koson/os/Backplane/renders/3d-full.png

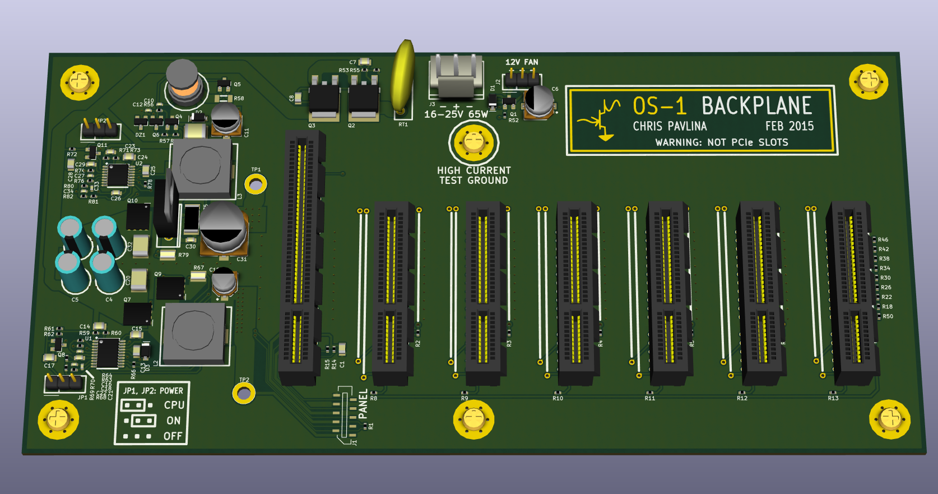
Backplane/renders/3d-full.png
