koson/os/Backplane/renders/render_2l_small.png

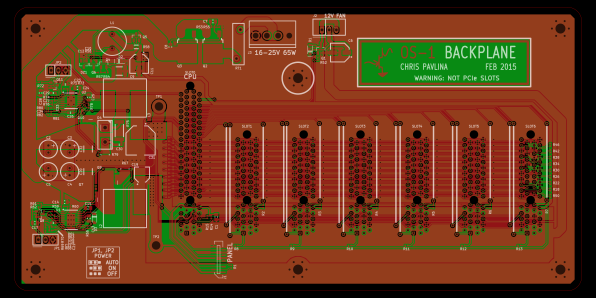
Backplane/renders/render_2l_small.png
