koson/os/README.rst

I'm building an oscilloscope!

See the `project page`_.

.. _`project page`: http://cpavlina.github.io/os/
