koson/os/Backplane/renders/page_os-backplane.png

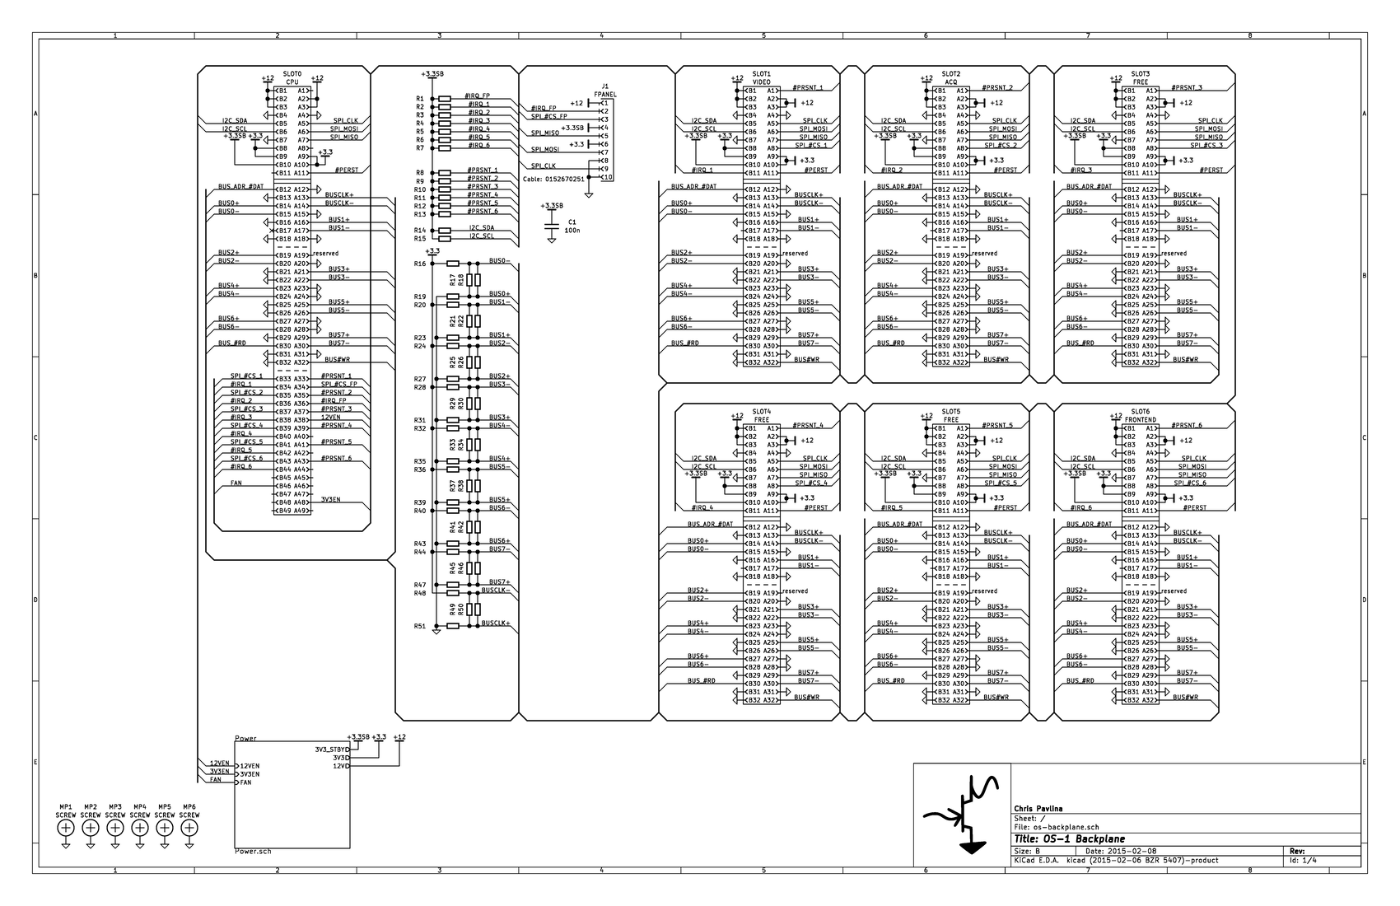
Backplane/renders/page_os-backplane.png
