koson/os/Backplane/renders/page_Power-Power.png

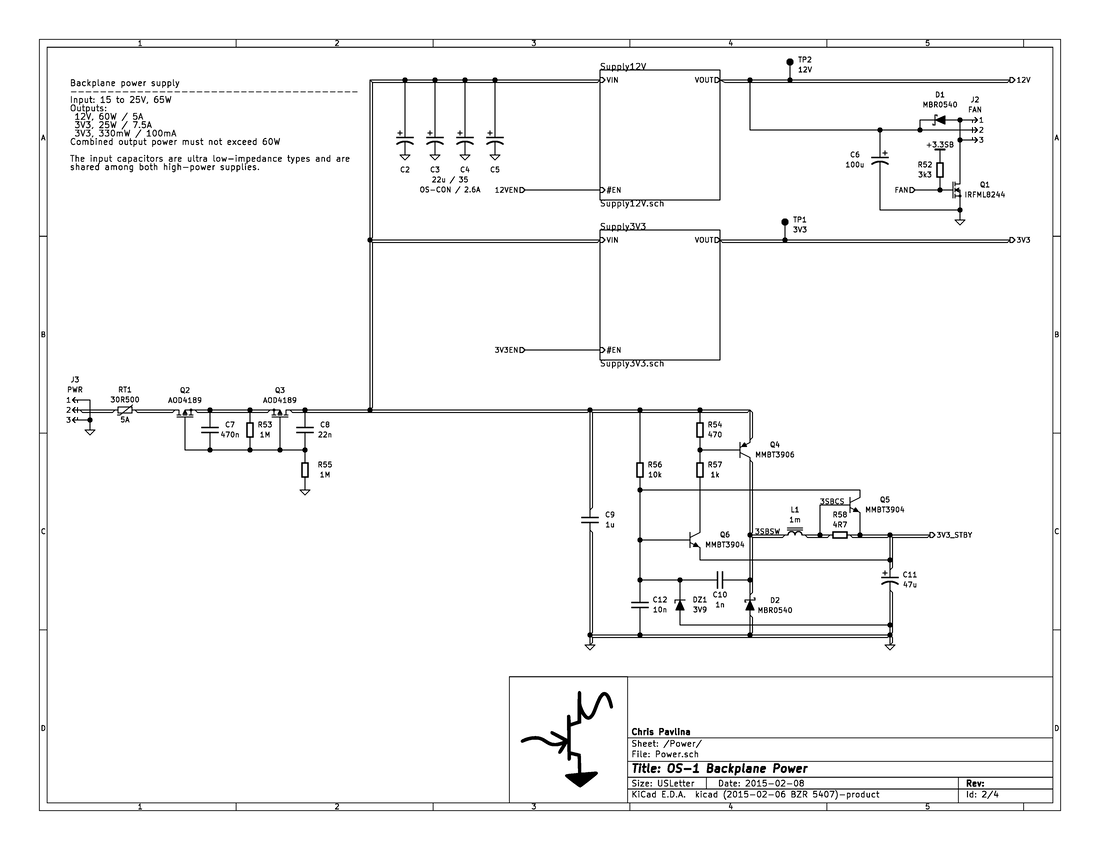
Backplane/renders/page_Power-Power.png
