koson/os/Backplane/renders/page_Supply3V3-Power-Supply3V3.png

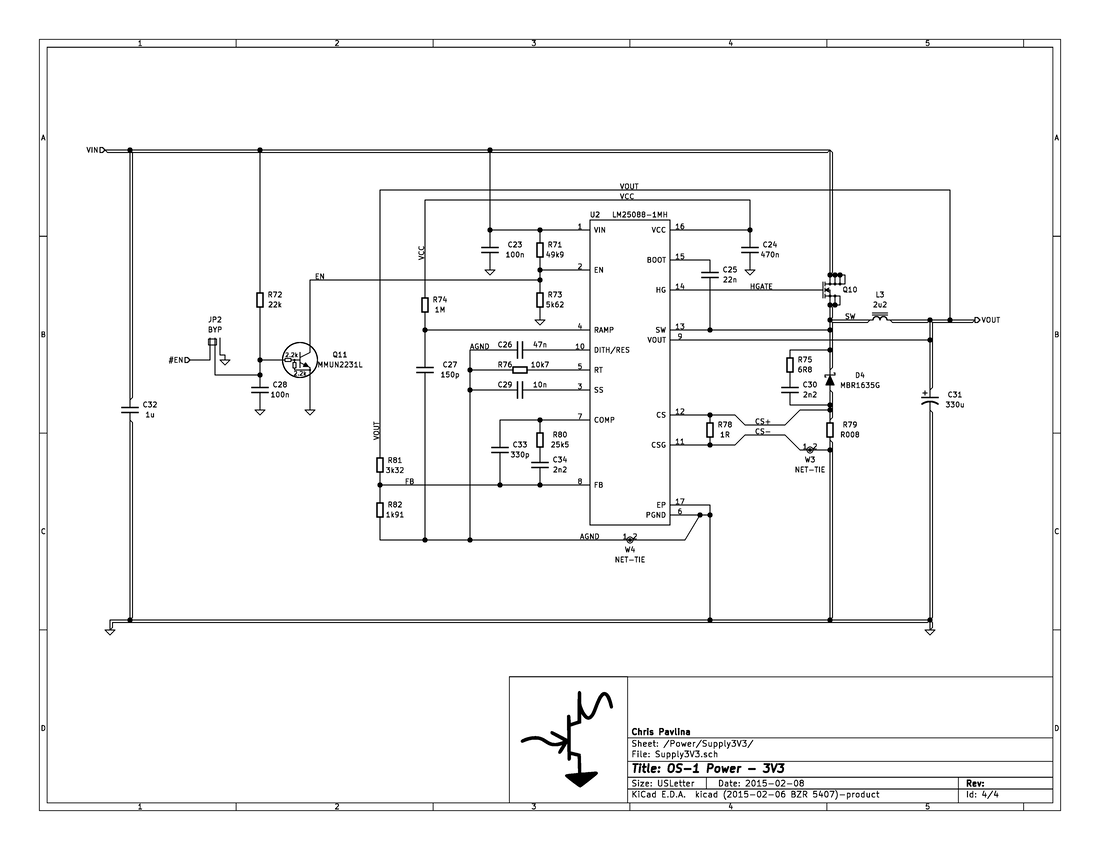
Backplane/renders/page_Supply3V3-Power-Supply3V3.png
