koson/os/Backplane/renders/page_Supply12V-Power-Supply12V.png

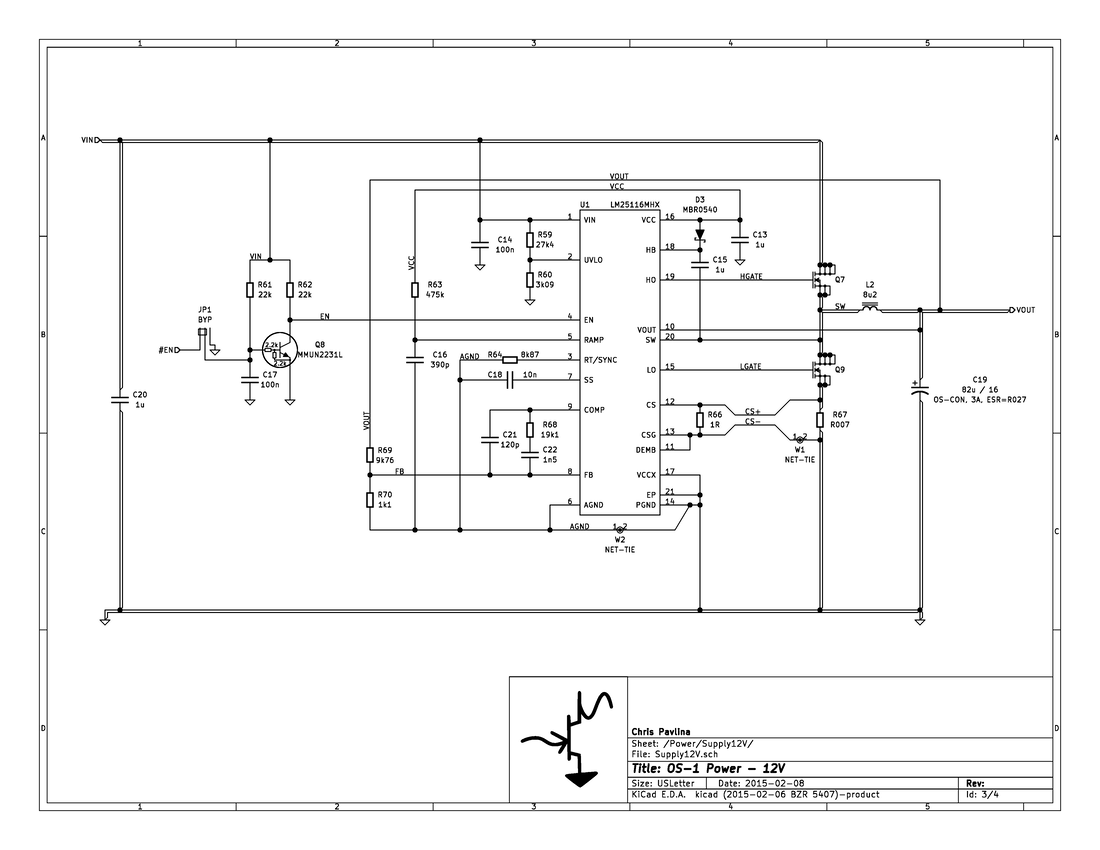
Backplane/renders/page_Supply12V-Power-Supply12V.png
