koson/os/Backplane/renders/render_lyr1.png

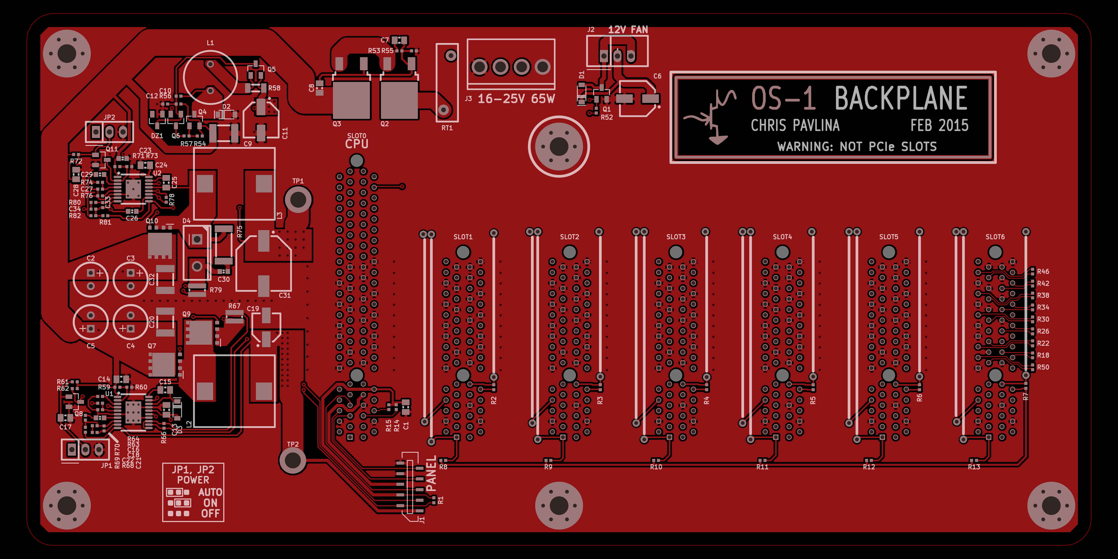
Backplane/renders/render_lyr1.png
