koson/os/Backplane/renders/render_lyr2.png

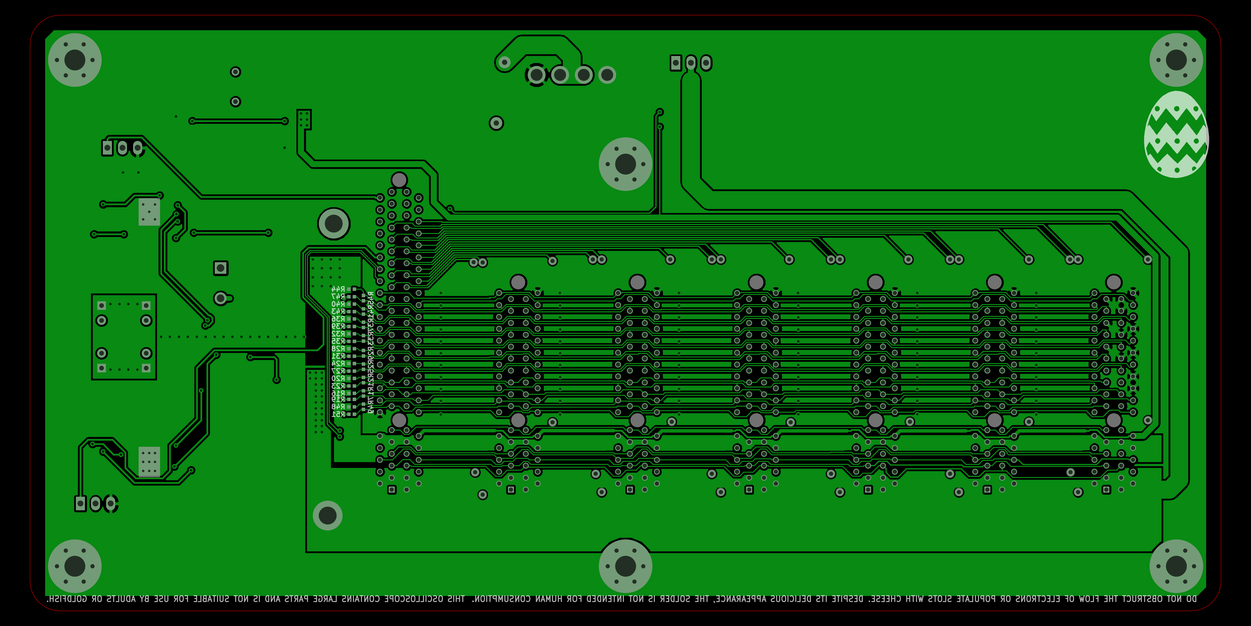
Backplane/renders/render_lyr2.png
