koson/os/Backplane/renders/schematic_small.png

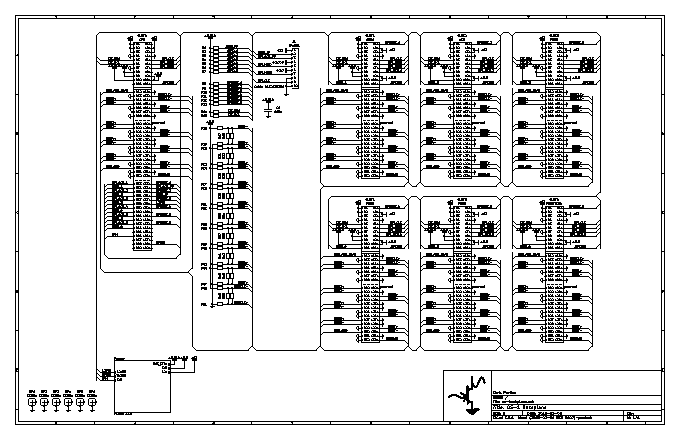
Backplane/renders/schematic_small.png
