koson/os/Frontend/Planning/Attens.png

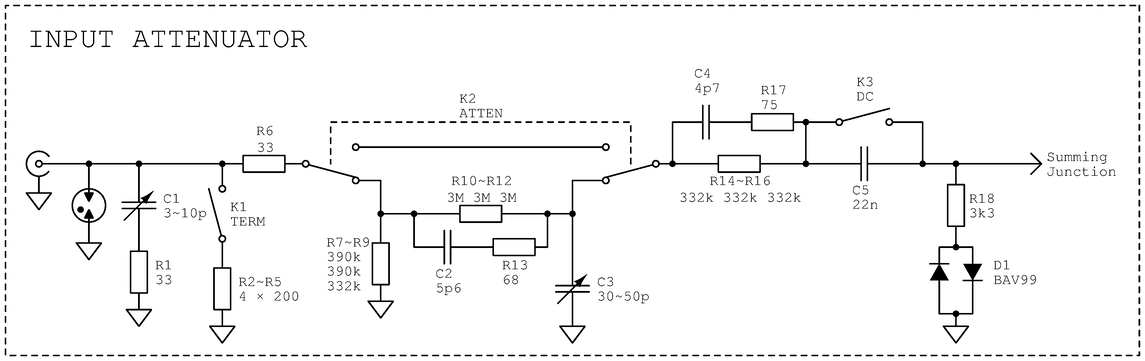
Frontend/Planning/Attens.png
