koson/os/Frontend/Planning/BlockDiag.png

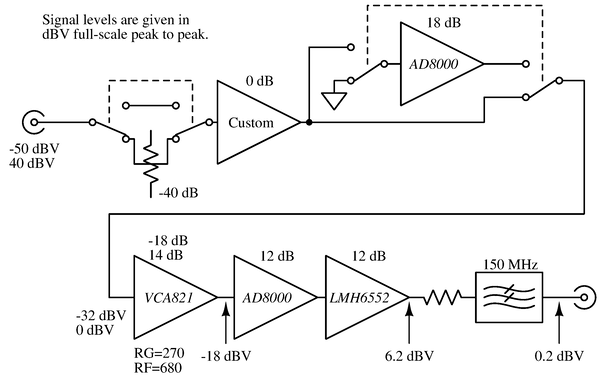
Frontend/Planning/BlockDiag.png
