koson/os/Frontend/renders/B_Cu.png

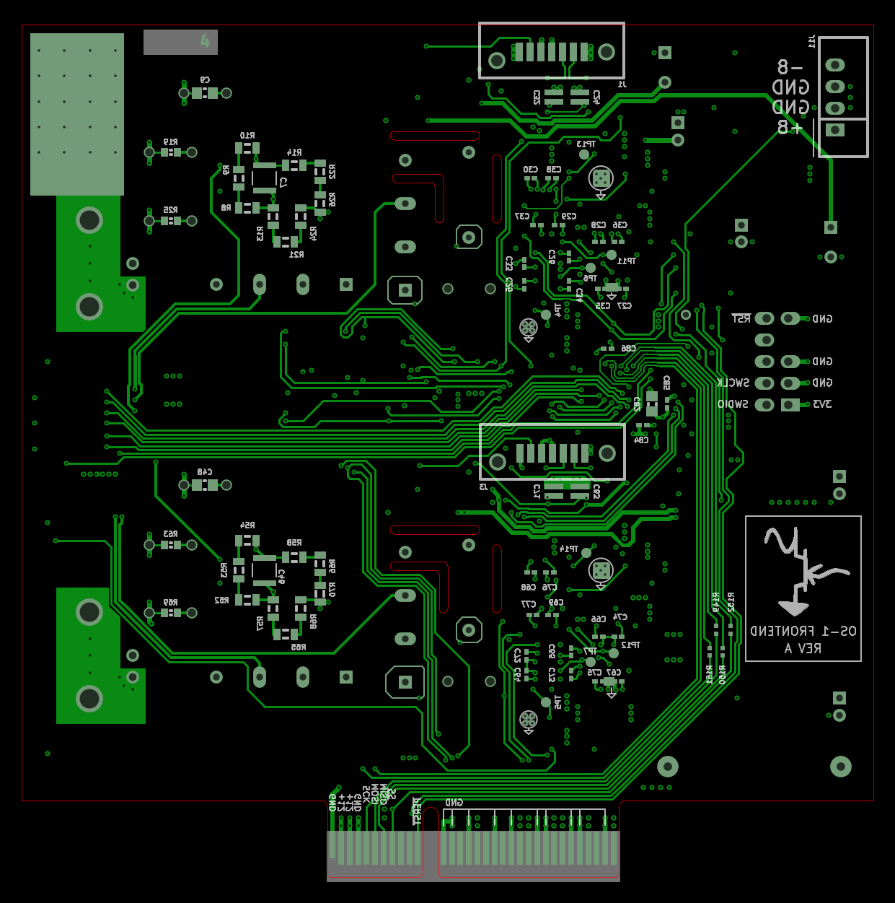
Frontend/renders/B_Cu.png
