koson/os/Frontend/renders/F_Cu.png

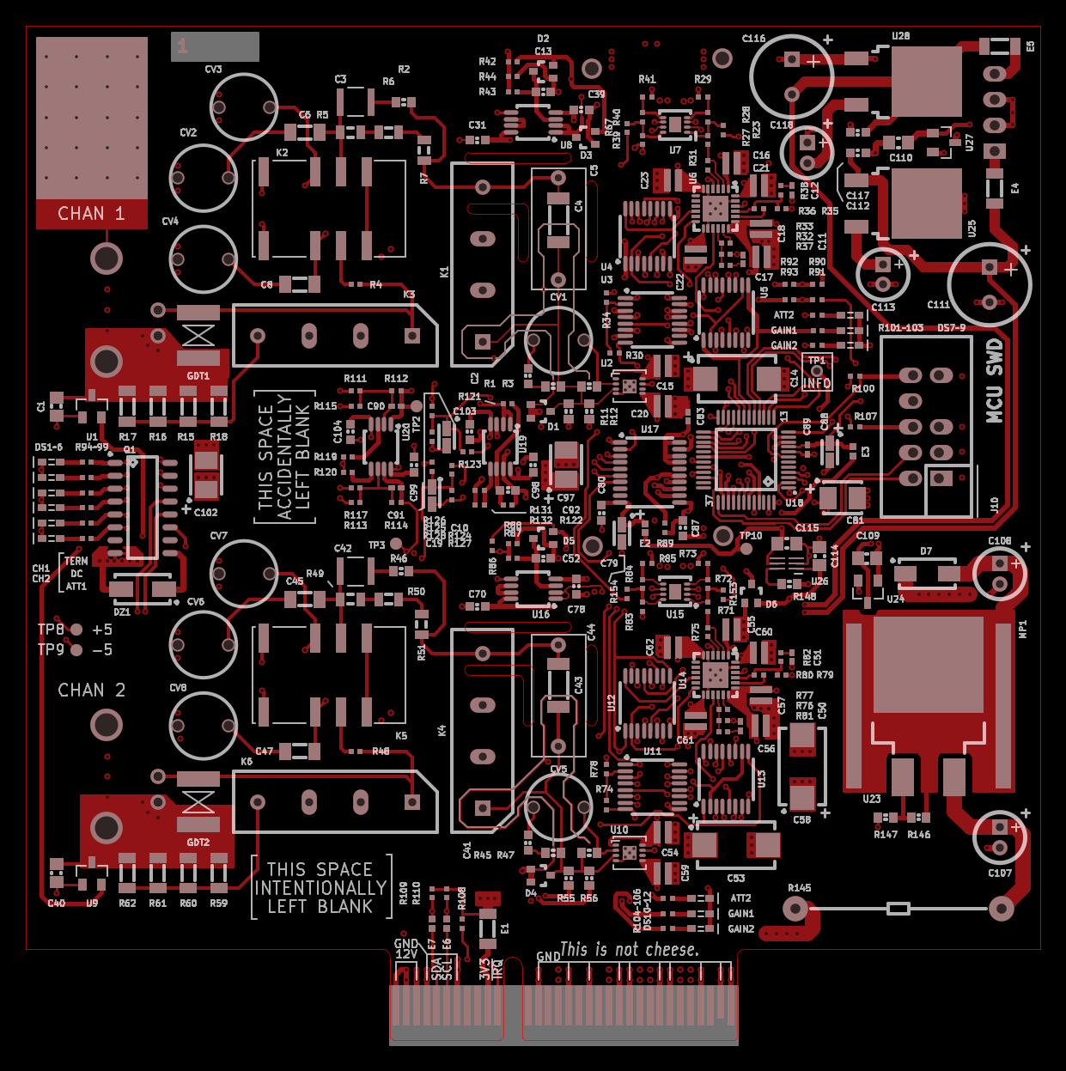
Frontend/renders/F_Cu.png
