koson/os/Frontend/renders/In1_Cu.png

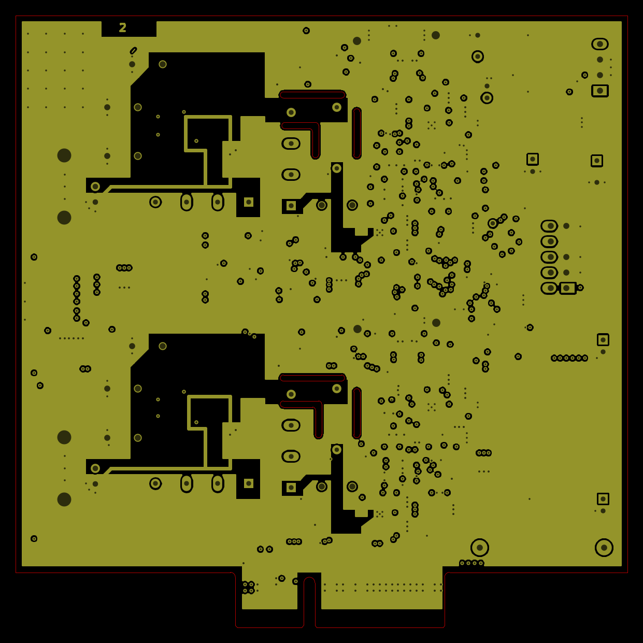
Frontend/renders/In1_Cu.png
