koson/os/Frontend/renders/In2_Cu.png

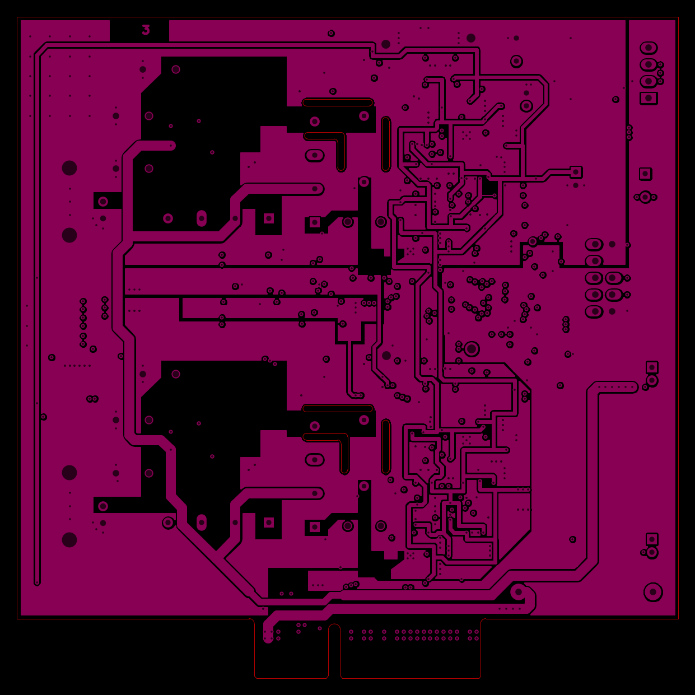
Frontend/renders/In2_Cu.png
