koson/os/Frontend/renders/Overview.png

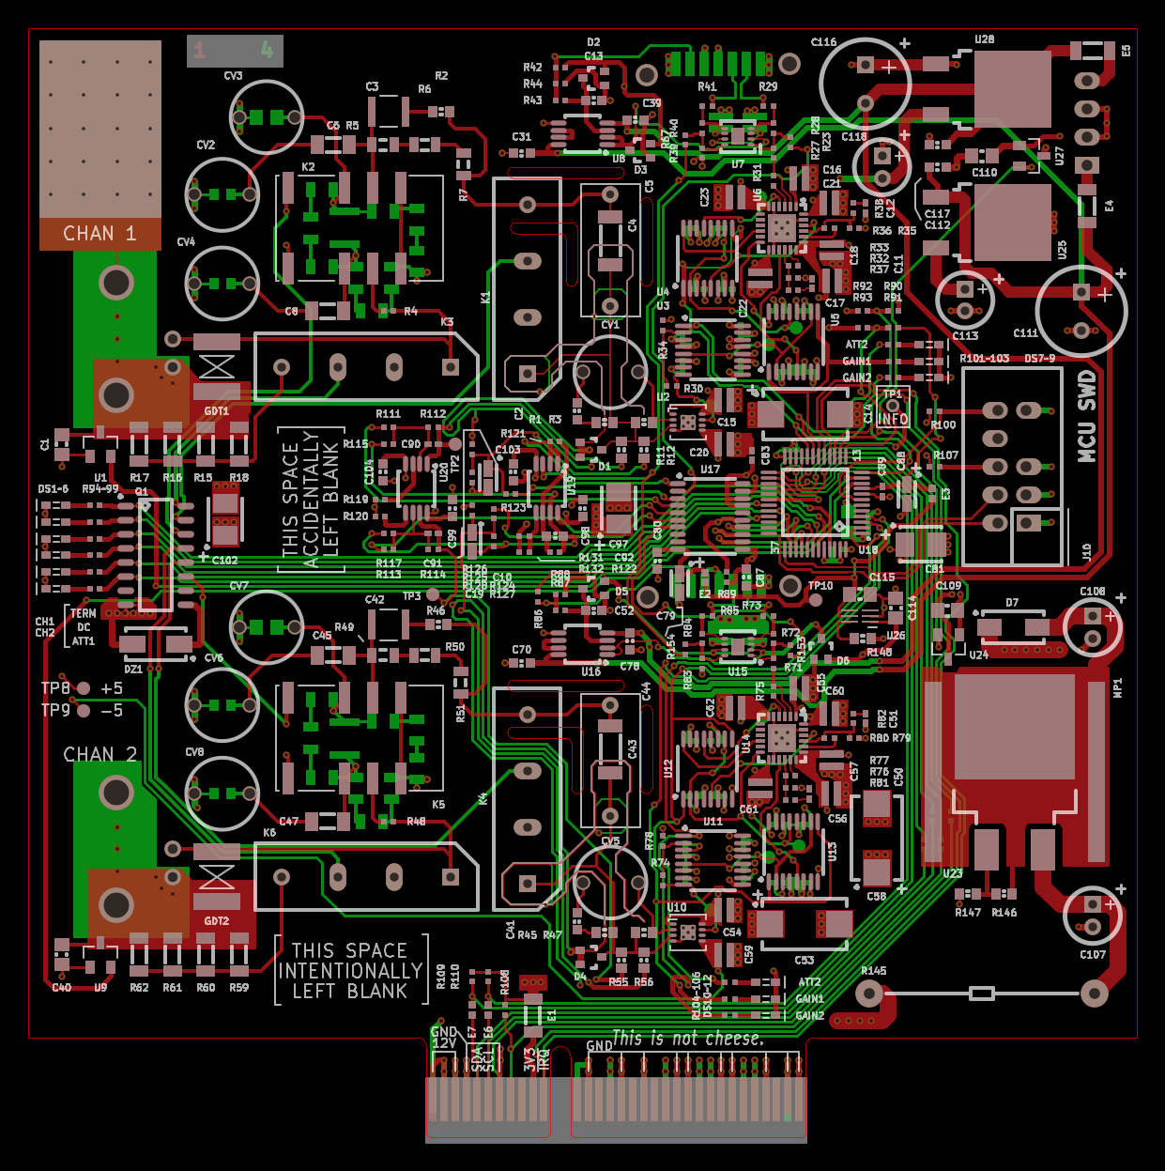
Frontend/renders/Overview.png
