koson/os/Frontend/frontend.pdf

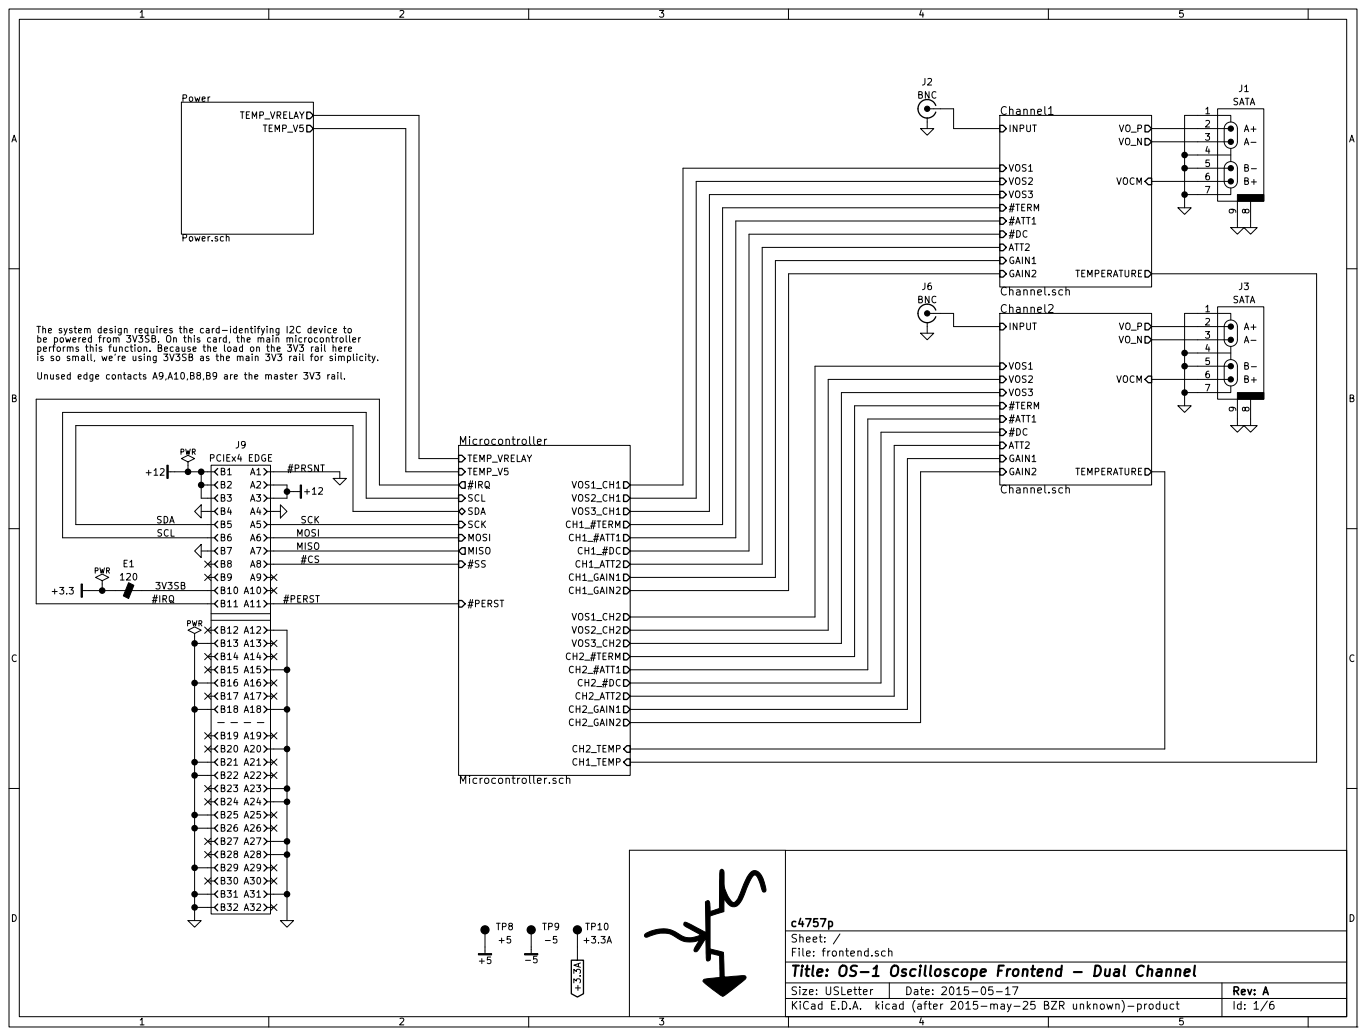
[picture p17: page 1]

The system design requires the card-identifying I2C device to
be powered from 3V3SB. On this card, the main microcontroller
performs this function. Because the load on the 3V3 rail here
is so small, we're using 3V3SB as the main 3V3 rail for simplicity.

Id: 1/6 Title: OS-1 Oscilloscope Frontend - Dual Channel File: frontend.sch Sheet: / c4757p

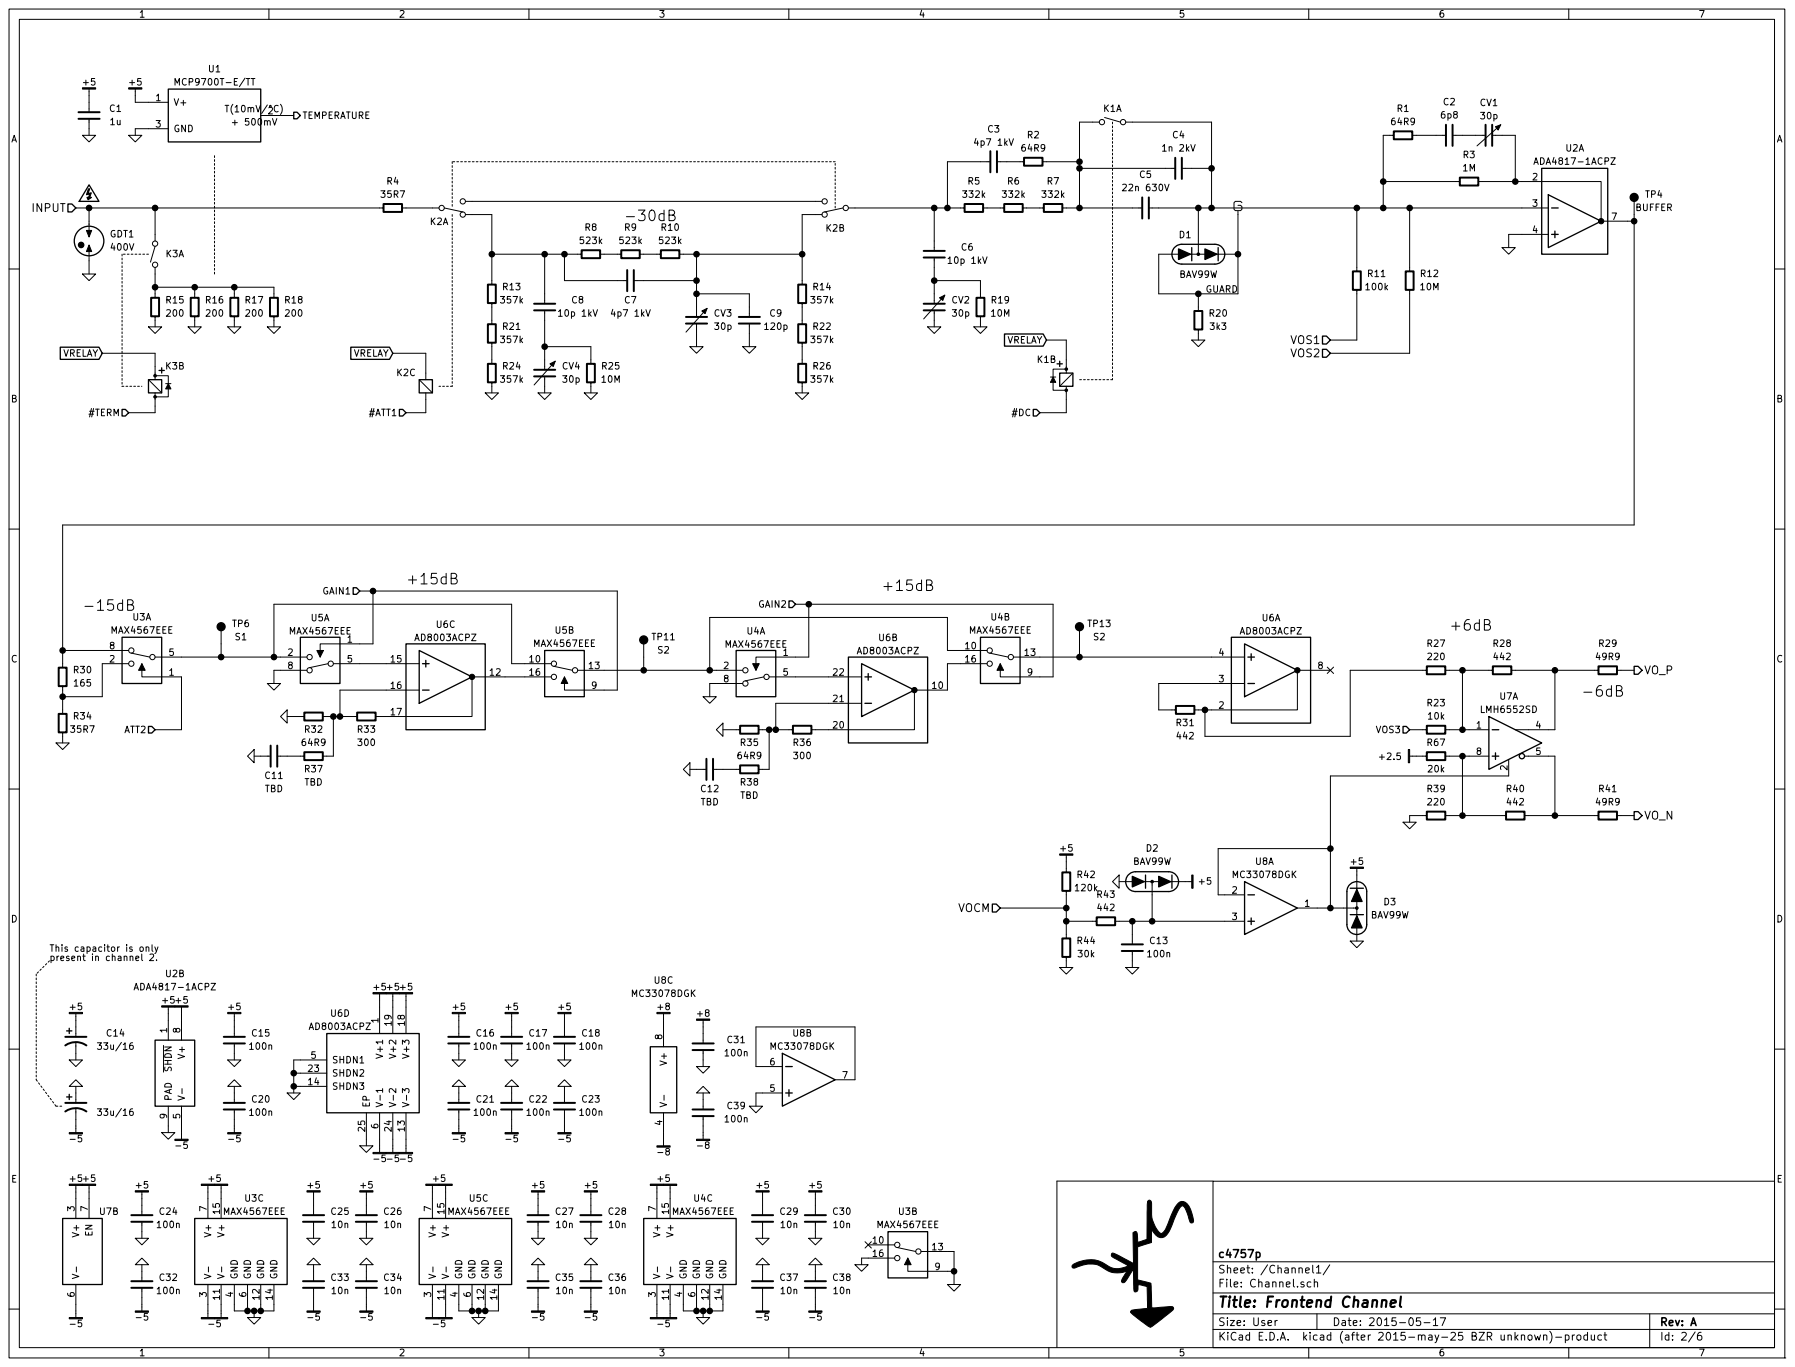
[picture p18: page 2]

This capacitor is only
present in channel 2.

Id: 2/6 Title: Frontend Channel File: Channel.sch Sheet: /Channel1/ c4757p

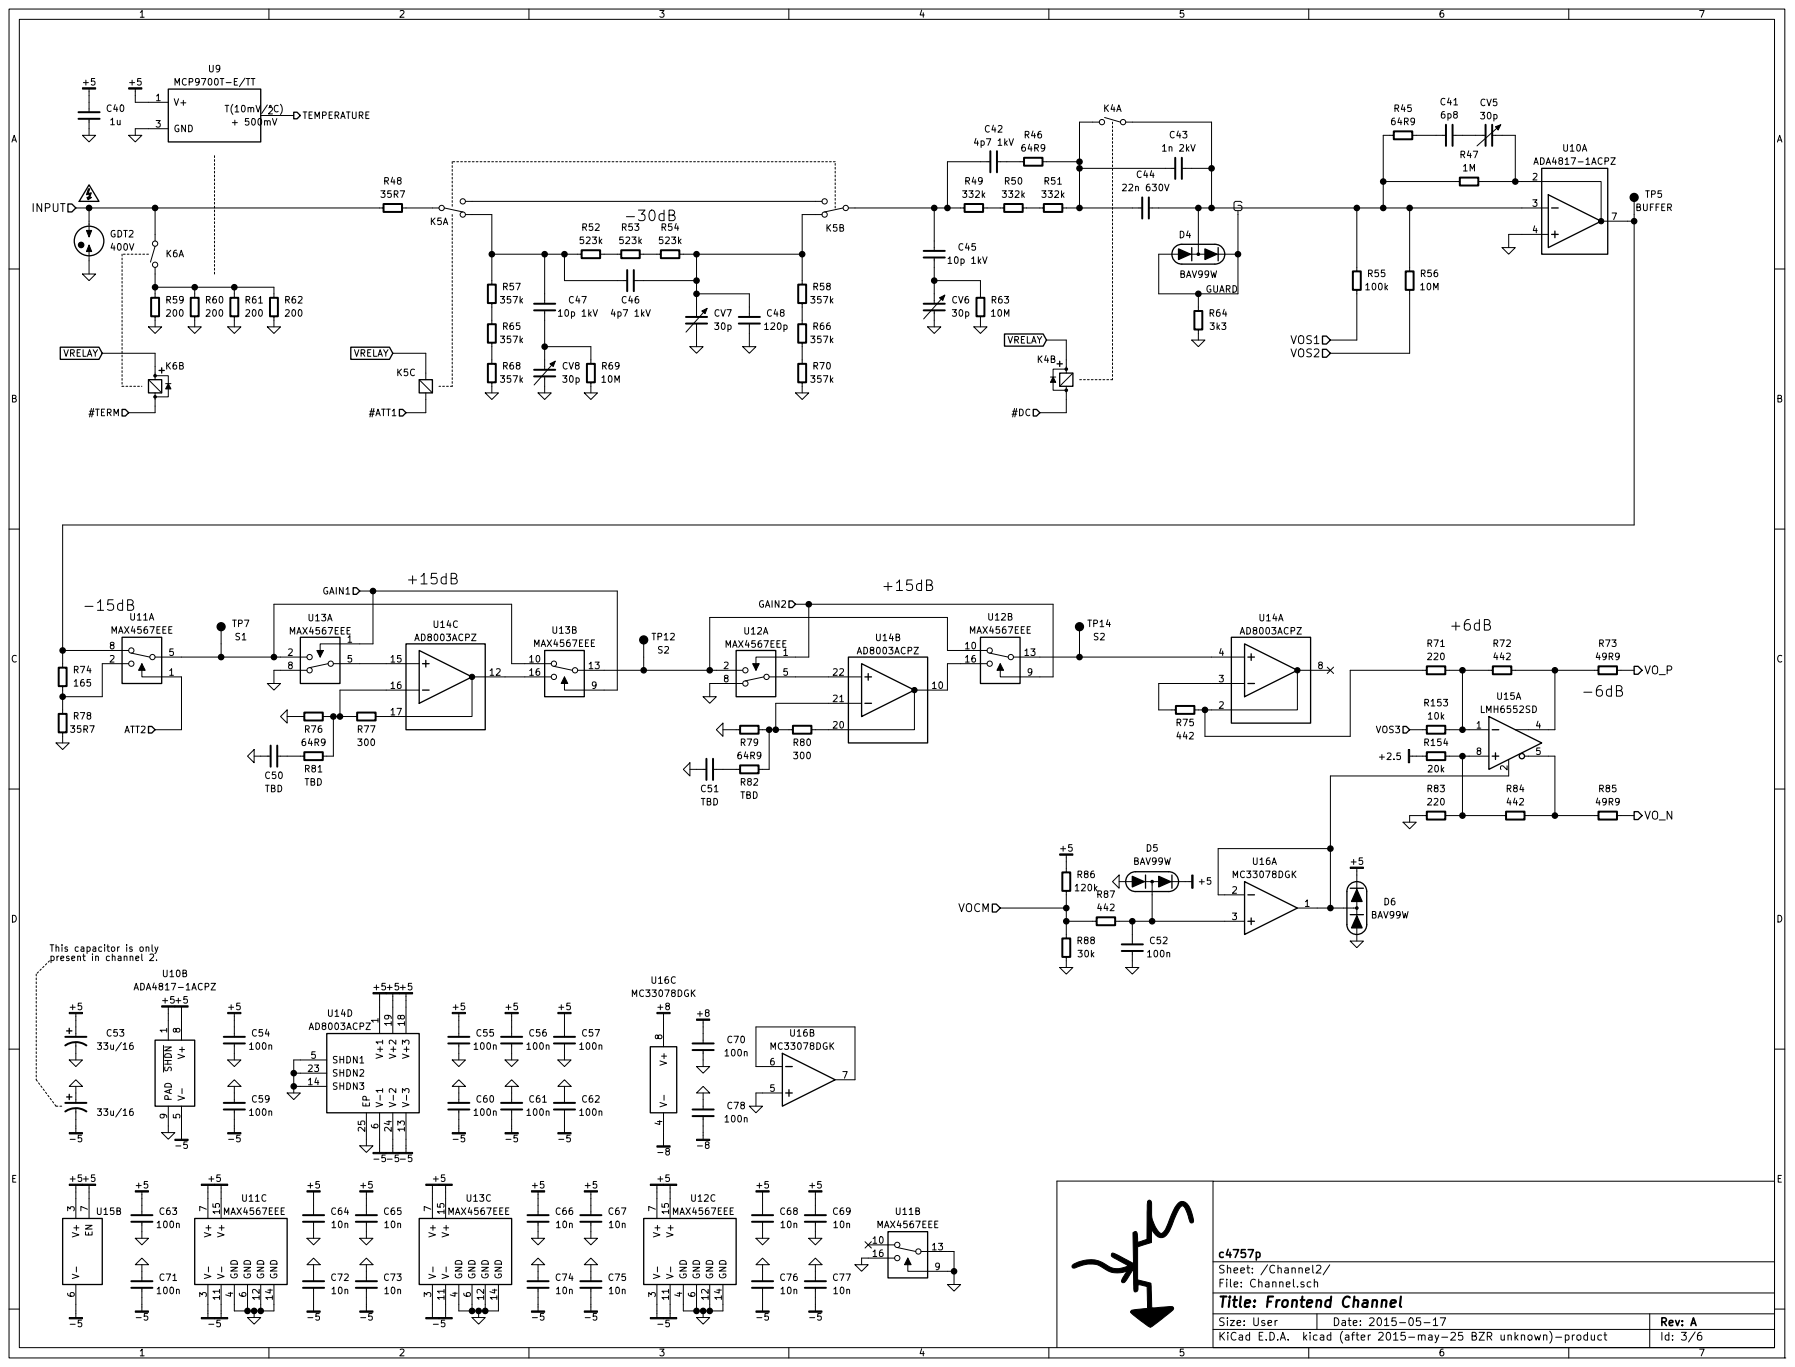
[picture p19: page 3]

This capacitor is only
present in channel 2.

Id: 3/6 Title: Frontend Channel File: Channel.sch Sheet: /Channel2/ c4757p

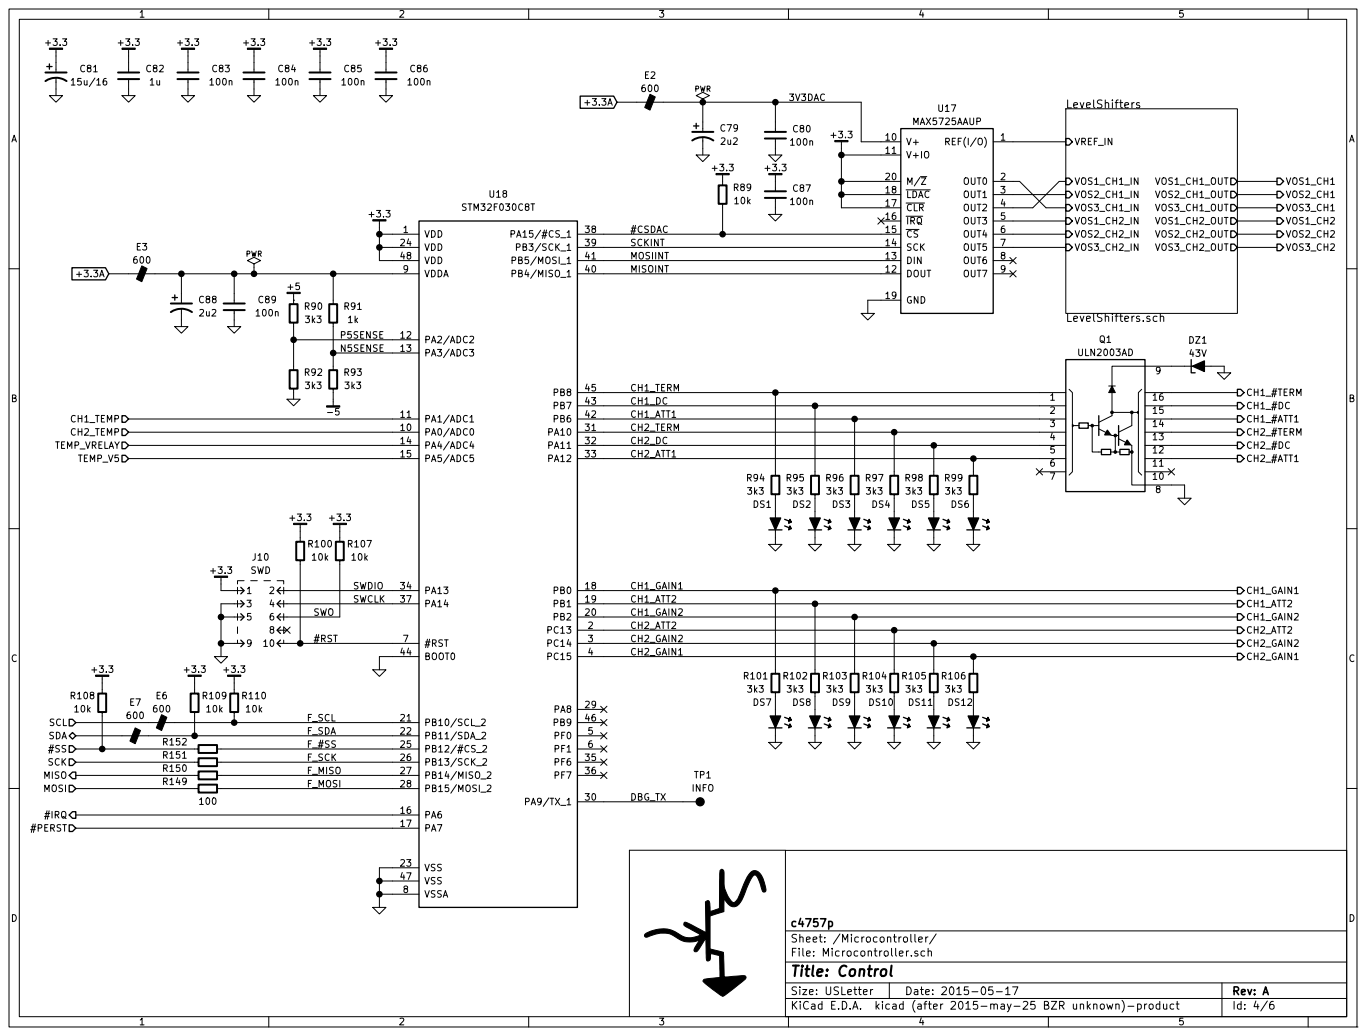
[picture p20: page 4]

CH1_DC | 1
CH1_ATT1 CH2_TERM | | 2

SWCLK

SWO

Id: 4/6 Title: Control File: Microcontroller.sch Sheet: /Microcontroller/ c4757p

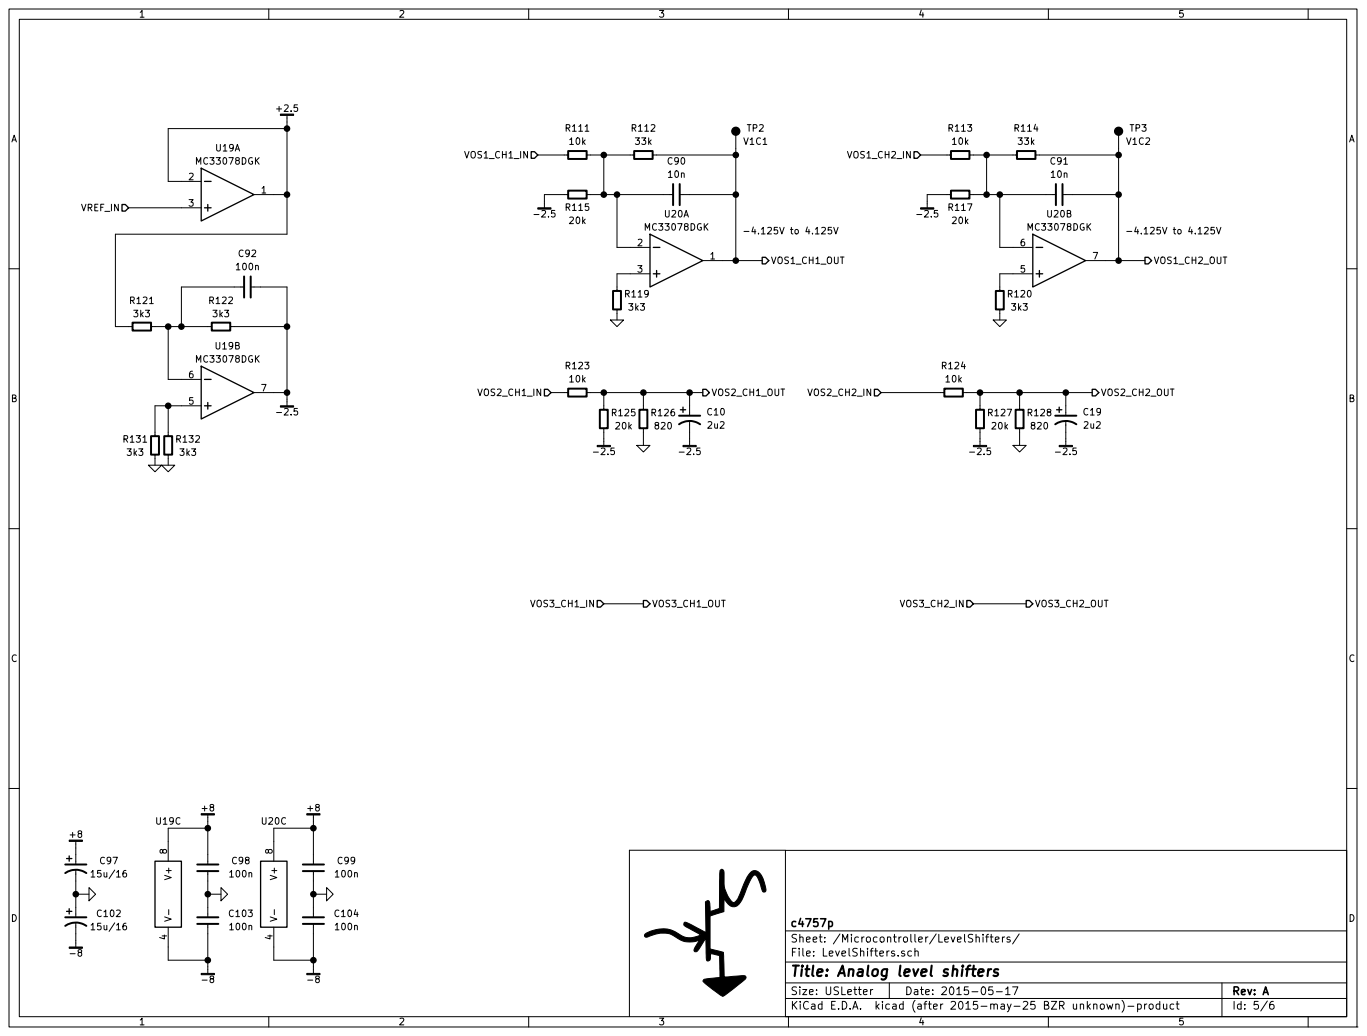
[picture p21: page 5]

File: LevelShifters.sch Sheet: /Microcontroller/LevelShifters/ c4757p

Id: 5/6 Title: Analog level shifters

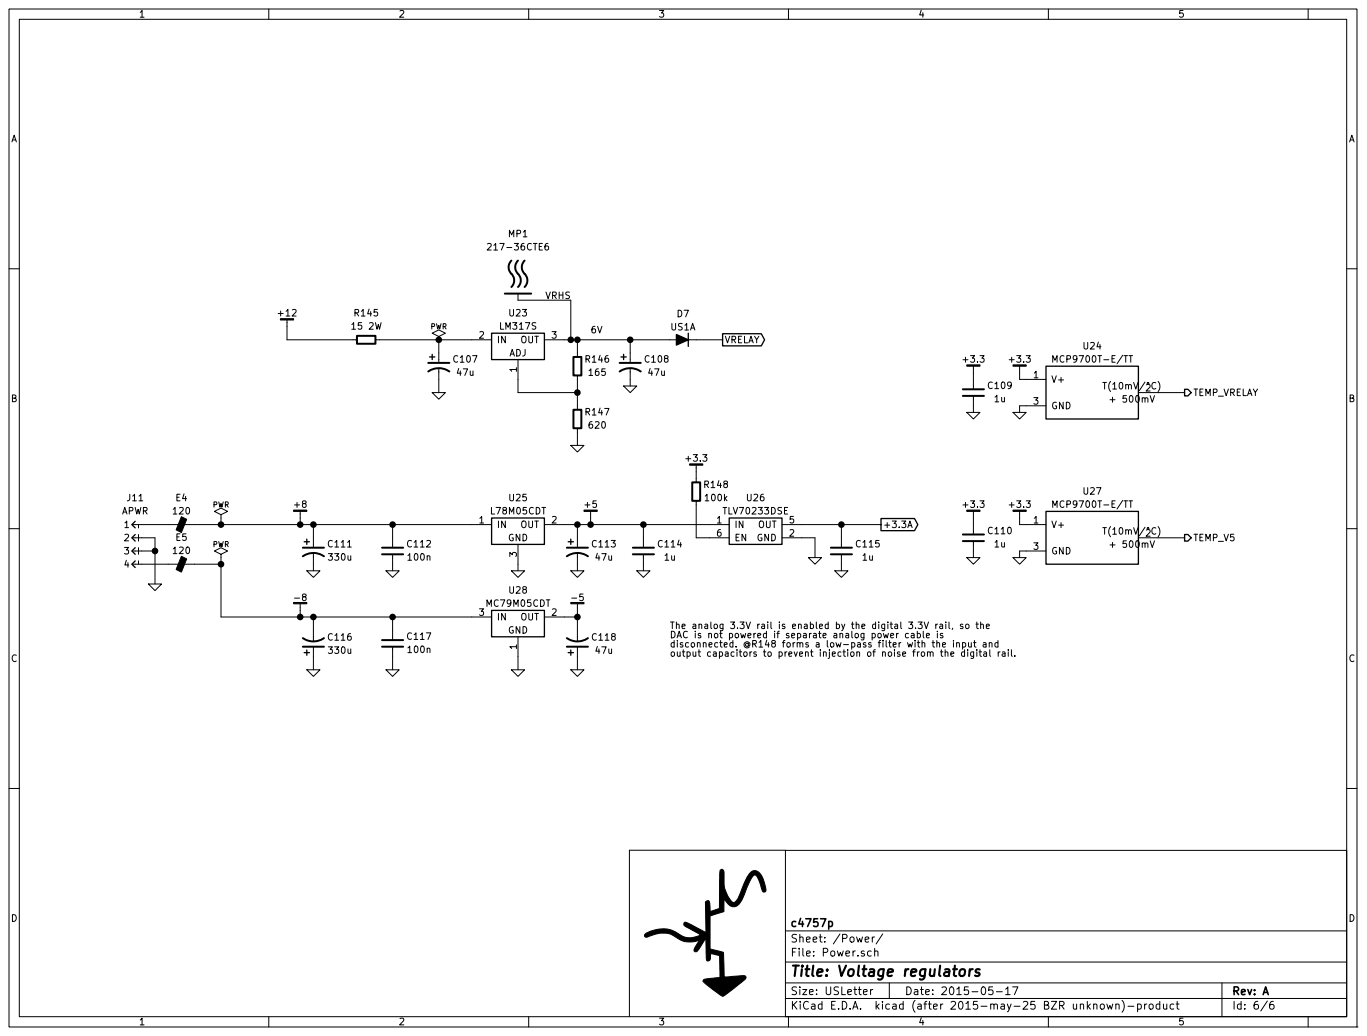
[picture p22: page 6]

100k +3.3 The analog 3.3V rail is enabled by the digital 3.3V rail, so the

output capacitors to prevent injection of noise from the digital rail. PWR

DAC is not powered if separate analog power cable is
disconnected. @R148 forms a low-pass filter with the input and

File: Power.sch Sheet: /Power/ c4757p

Id: 6/6 Title: Voltage regulators
