koson/os/Frontend/Planning/Attens.pdf

# INPUT ATTENUATOR

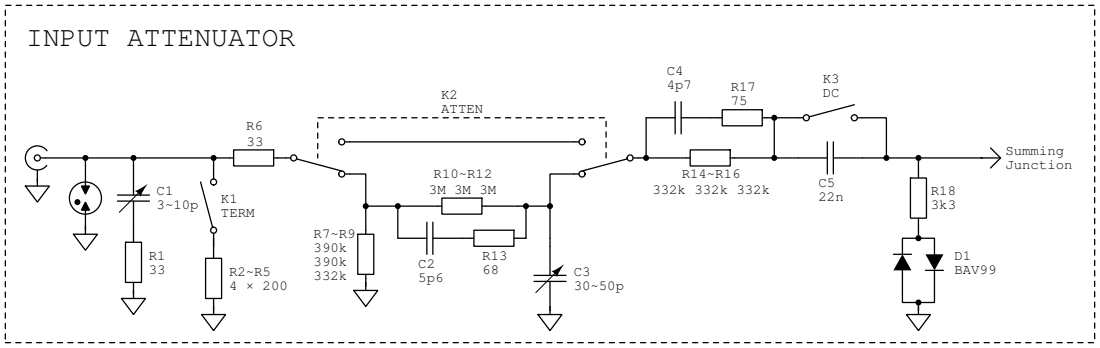
[picture p27: page 1]
