koson/os/Frontend/Planning/BlockDiag.pdf

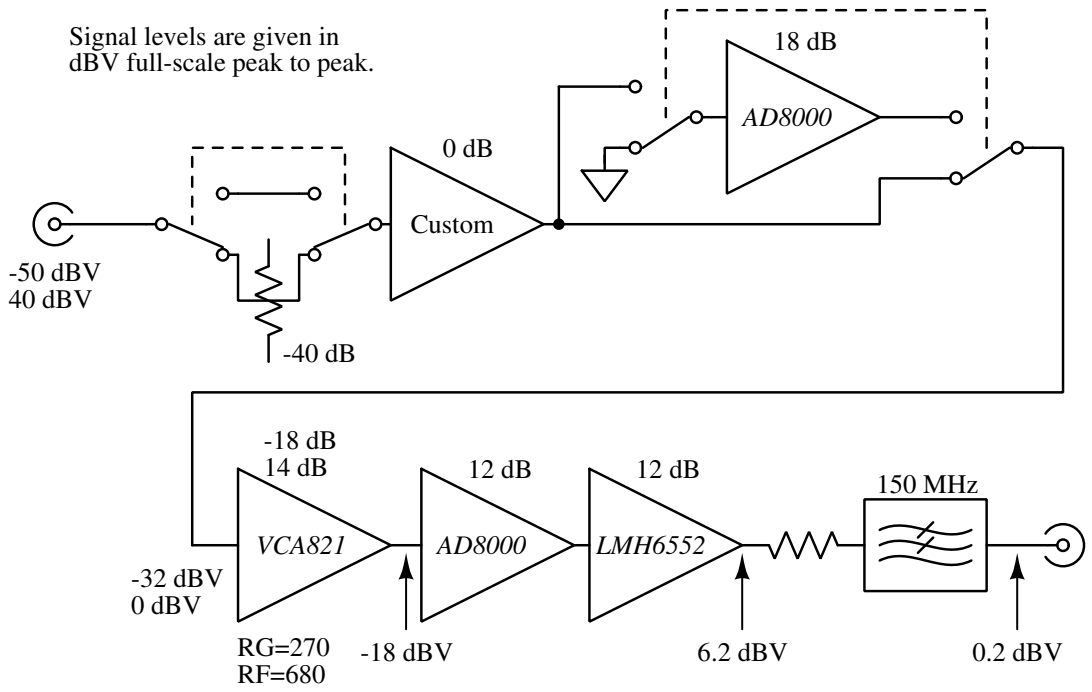
[picture p28: page 1]
0.2 dBV; -50 dBV 40 dBV; 6.2 dBV; VCA821; -32 dBV 0 dBV; LMH6552; -18 dBV; Custom; 150 MHz

Signal levels are given in
dBV full-scale peak to peak.
