koson/os/Frontend/Sim2/attensOnly.asc

C1: cap; 100n; Rser=.01
C2: cap; 100n; Rser=.01
C3: cap; 4p7
C4: cap; 3p9
C5: cap; 22n
C6: cap; 7p
C10: cap; 12p
C14: cap; 5p
C15: cap; 142p
C16: cap; 7.0p
D1: diode; 1N4148
D2: diode; 1N4148
R1: res; 1k6
R2: res; 510
R3: res; 750
R4: res; 178
R5: res; 3k3
R6: res; 750
R7: res; 510
R8: res; 178
R9: res; 1k6
R15: res; 332k
R16: res; 332k
R17: res; 332k
R18: res; 75
R19: res; 75
R21: res; 1Meg
R29: res; 1Meg
R31: res; 1.06531e+06
R32: res; 1.57956e+07
R33: res; 1.06531e+06
U1: AD8000
U2: AD8000
U4: opamp2; ADA4817
V2: voltage; 5; Rser=.1
V3: voltage; -5; Rser=.1
V4: voltage; SINE(0 40 {freq}); AC 1
V6: voltage; 1
Named nets: 0, V+, V-, 1V
;tran {20/freq}
.param freq 60
.lib VCA821.sub
.ac dec 50 1k 1G
Signal levels assume full-scale signal
-54dBVp to 32dBVp
.lib ADA4817.sub
.lib diode.lib
