koson/os/Frontend/Sim2/Draft1.asc

B1: bv; V=V(A,B)
C1: cap; 100n; Rser=.01
C2: cap; 100n; Rser=.01
C3: cap; 4p7
C4: cap; 3p9
C5: cap; 3p3
C6: cap; 9p
C7: cap; 8.2p
C8: cap; 9p
C9: cap; 7.6p
C10: cap; 12p
C11: cap; 6p9
C12: cap; 5.5p
C13: cap; 5.5p
C14: cap; 4p7
C15: cap; 29p
C16: cap; 8.5p
R1: res; 220
R2: res; 470
R3: res; 33
R4: res; 560
R5: res; 160
R6: res; 150
R7: res; 680
R8: res; 150
R9: res; 680
R10: res; 50
R11: res; 100
R12: res; 50
R13: res; 1
R14: res; 3k3
R15: res; 332k
R16: res; 332k
R17: res; 332k
R18: res; 75
R19: res; 75
R20: res; 1.92495e+06
R21: res; 1Meg
R22: res; 1.42302e+06
R23: res; 1.92495e+06
R24: res; 22
R25: res; 1.92495e+06
R26: res; 1.42302e+06
R27: res; 1.92495e+06
R28: res; 22
R29: res; 1Meg
R30: res; 3.3
R31: res; 1.22222e+06
R32: res; 4.95e+06
R33: res; 1.22222e+06
U1: VCA821; VCA821_Model
U2: AD8000
U3: LMH6552
U4: opamp2; ADA4817
V1: voltage; .86
V2: voltage; 5; Rser=.1
V3: voltage; -5; Rser=.1
V4: voltage; SINE(0 15.85m {freq}); AC 1
V5: voltage; -13.861m
V6: voltage; 1
Named nets: 0, V+, V-, 1V, A, B, diff
;tran {20k/freq}
.param freq 10Meg
.lib VCA821.sub
.ac dec 50 1k 1G
-20 to 6 dB
Desired: -20dBm
-10dBVp
Signal levels assume full-scale signal
-17dBVp
-30dBVp
-36dBVp to -10dBVp
-54dBVp to 32dBVp
-54dBVp to 32dBVp
.lib ADA4817.sub
.lib diode.lib
