koson/os/Frontend/frontend.kicad_pcb

## KiCad design Frontend/frontend.kicad_pcb (continued)

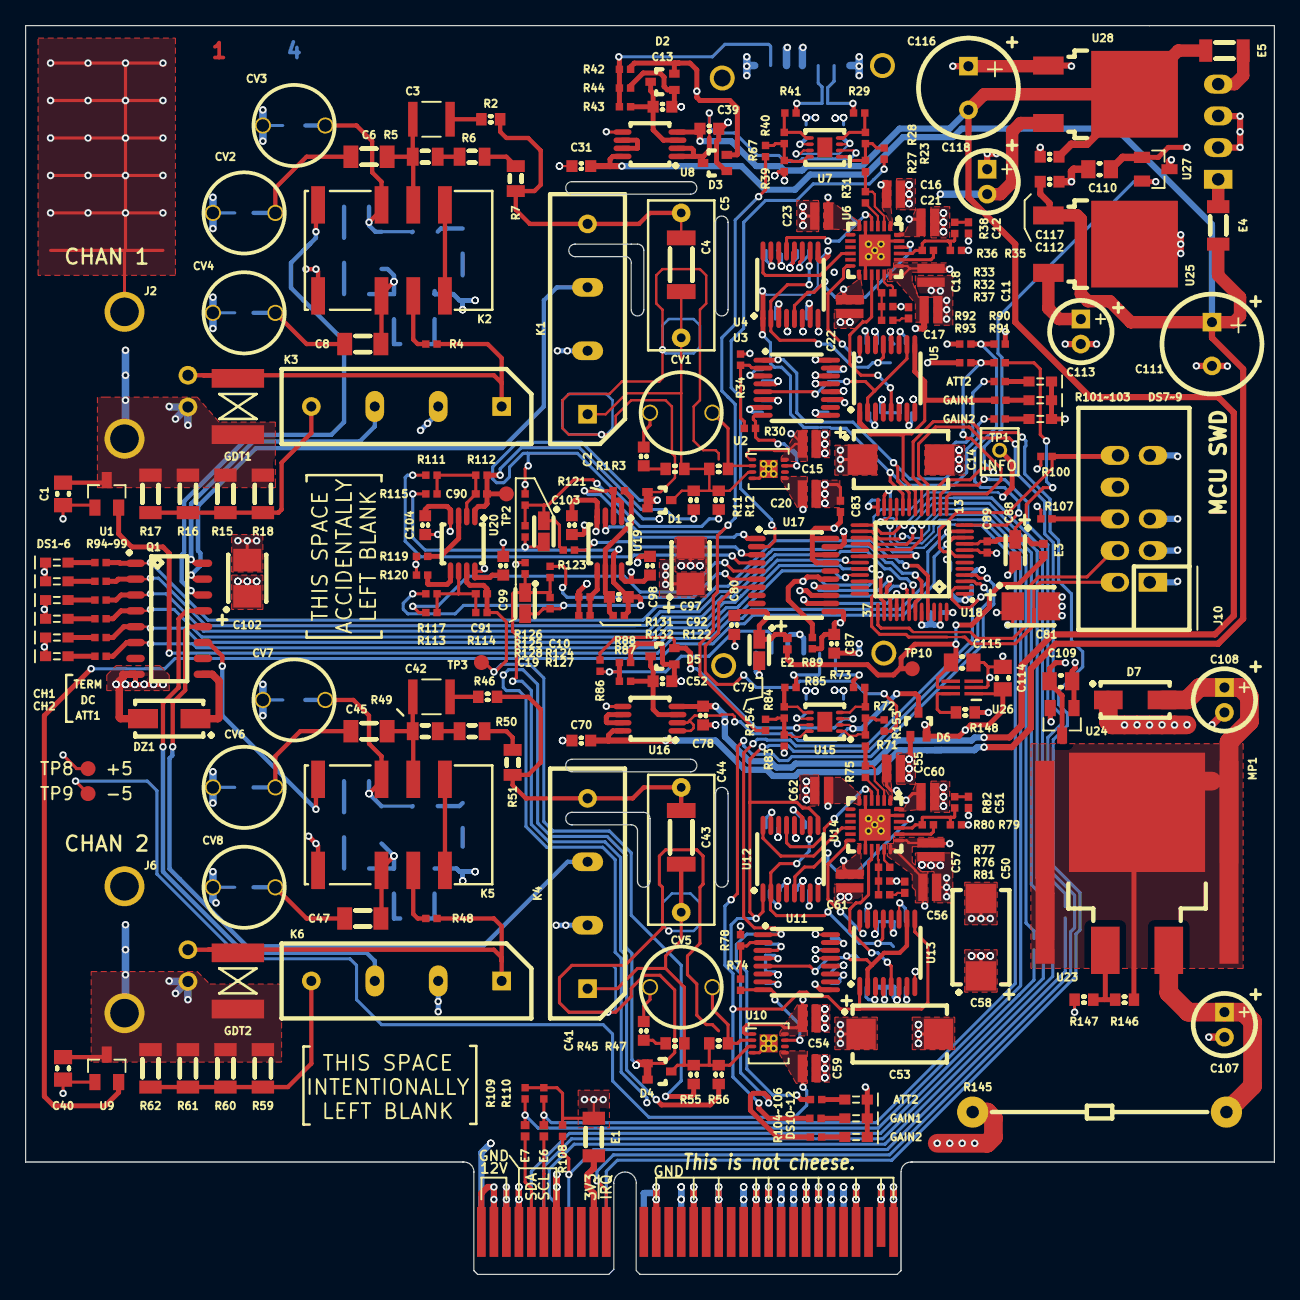
[picture p34: board frontend.kicad_pcb from above]

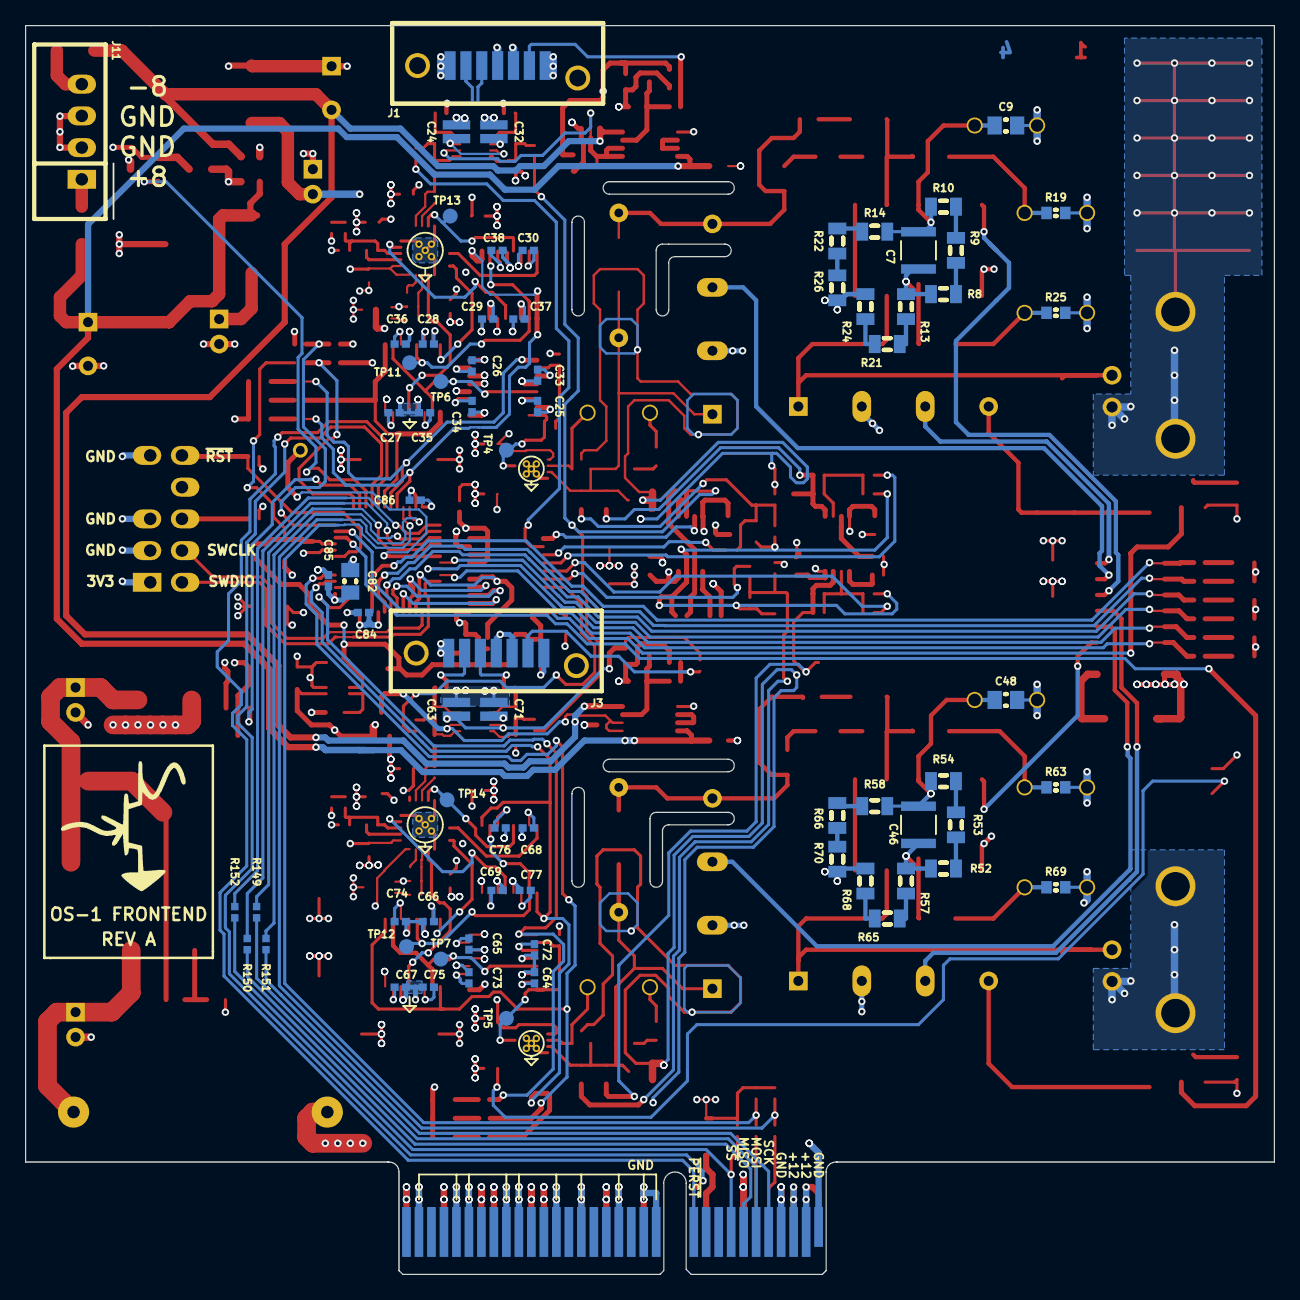
[picture p35: board frontend.kicad_pcb from below]

Board: 4 copper layers, 100.0 x 100.0 mm, 337 parts (73 on the bottom side), 197 nets.

Other parts of the board:
C58: 33u/16; CAPMP7343X310
