koson/os/PSU3V3/psu3v3.kicad_pcb

## KiCad design PSU3V3/psu3v3.kicad_pcb (2015-05-10)

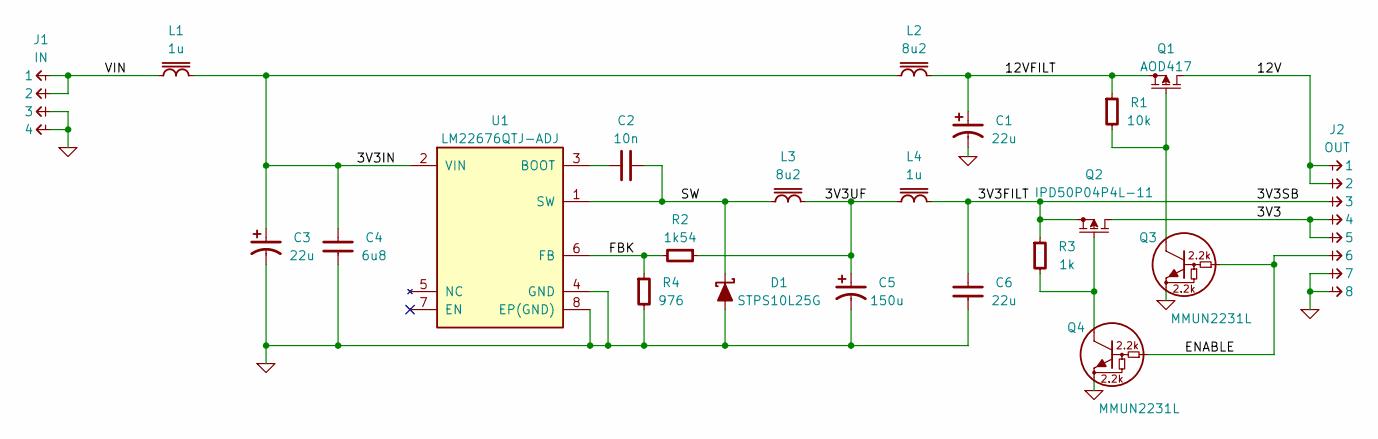
[picture p36: schematic psu3v3.sch]

Parts:
C1, C3: 22u; CAPAE660X570
C2: 10n; CAPC2012X70
C4: 6u8; CAPC3225X88
C5: 150u; CAPAE1030X1250
C6: 22u; CAPC3216X70
D1: STPS10L25G; TO-263
J1: IN; CONN-100MIL-M-1x4
J2: OUT; CONN-100MIL-M-1x8
L1, L4: 1u; BOURNS-SRR1210
L2, L3: 8u2; BOURNS-SRP1238A
Q1: AOD417; TO-252
Q2: IPD50P04P4L-11; TO-252
Q3, Q4: MMUN2231L; SOT-23
R1: 10k; RESC2012X50
R2: 1k54; RESC2012X50
R3: 1k; RESC2012X50
R4: 976; RESC2012X50
U1: LM22676QTJ-ADJ; TO-263-7-TEXAS

Connections:
/3V3: J2.4, J2.5, Q2.3 (D)
/3V3FILT: C6.1, J2.3, L4.1, Q2.2 (S), R3.1
/3V3IN: C3.1, C4.1, L1.1, L2.2, U1.2 (VIN)
/3V3UF: C5.1, L3.1, L4.2, R2.1
/12V: J2.1, J2.2, Q1.3 (D)
/12VFILT: C1.1, L2.1, Q1.2 (S), R1.1
/ENABLE: J2.6, Q3.1, Q4.1
/FBK: R2.2, R4.1, U1.6 (FB)
/SW: C2.1, D1.3 (K), L3.2, U1.1 (SW)
/VIN: J1.1, J1.2, L1.2
GND: C1.2, C3.2, C4.2, C5.2, C6.2, D1.2 (A), J1.3, J1.4, J2.7, J2.8, Q3.2, Q4.2, R4.2, U1.4 (GND), U1.8 (EP(GND))
unnamed: C2.2, U1.3 (BOOT)
unnamed: Q1.1 (G), Q3.3, R1.2
unnamed: Q2.1 (G), Q4.3, R3.2

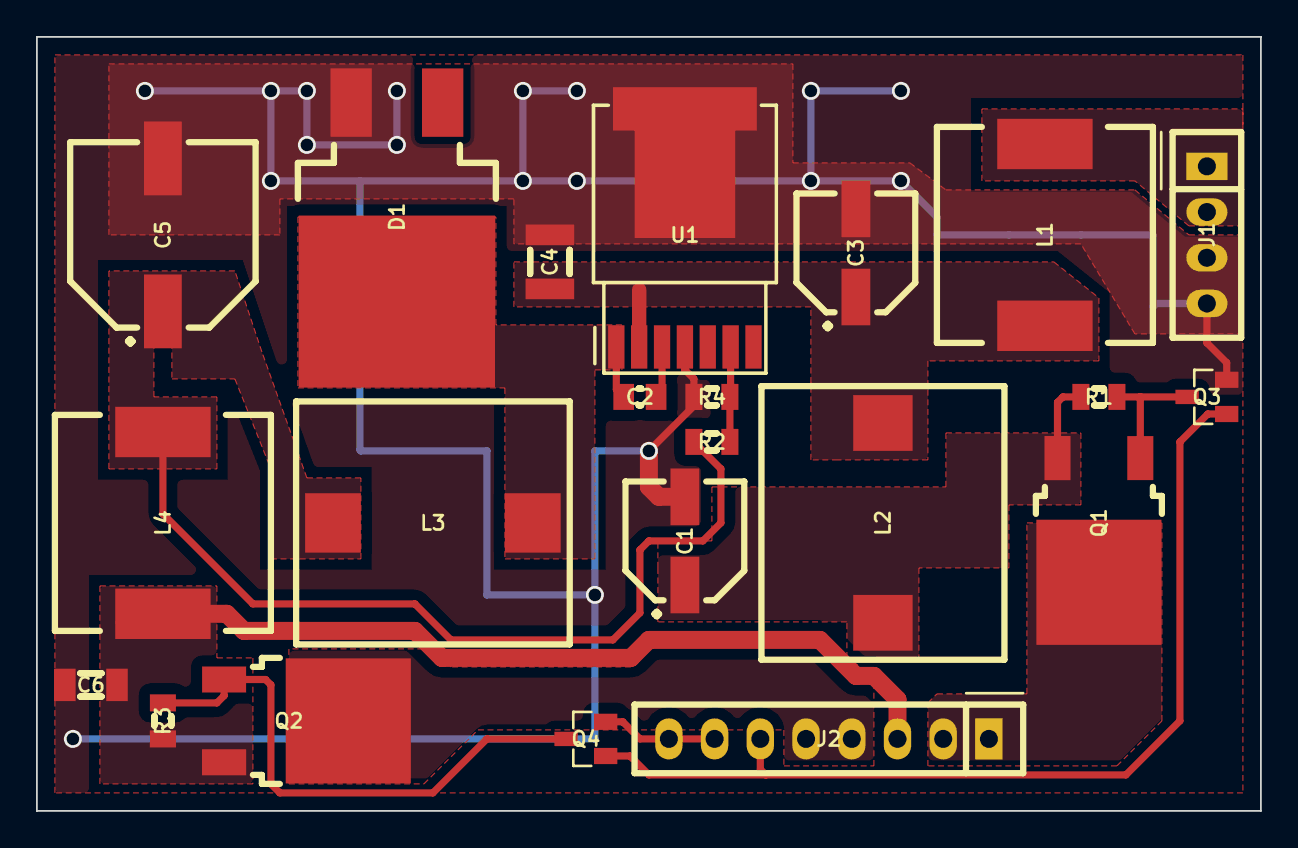
[picture p37: board psu3v3.kicad_pcb from above]

Board: 2 copper layers, 68.0 x 43.0 mm, 22 parts (0 on the bottom side), 14 nets.
