koson/os/Backplane/os-backplane.kicad_pcb

## KiCad design Backplane/os-backplane.kicad_pcb (continued)

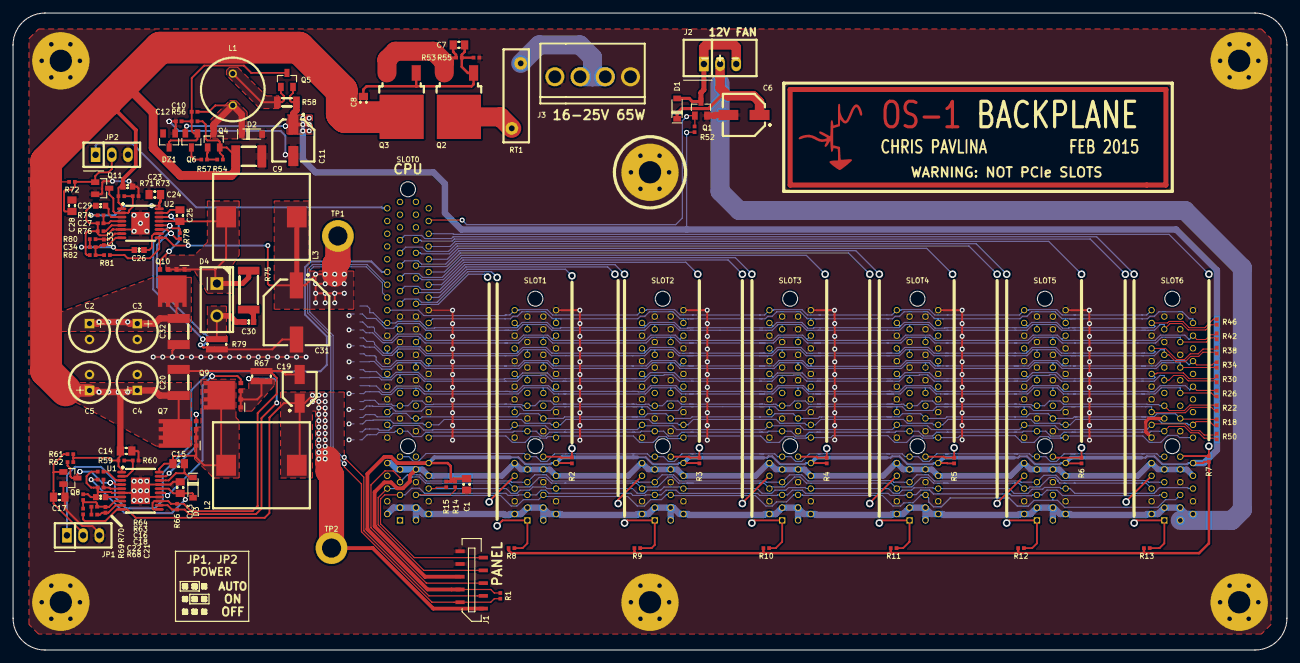
[picture p42: board os-backplane.kicad_pcb from above]

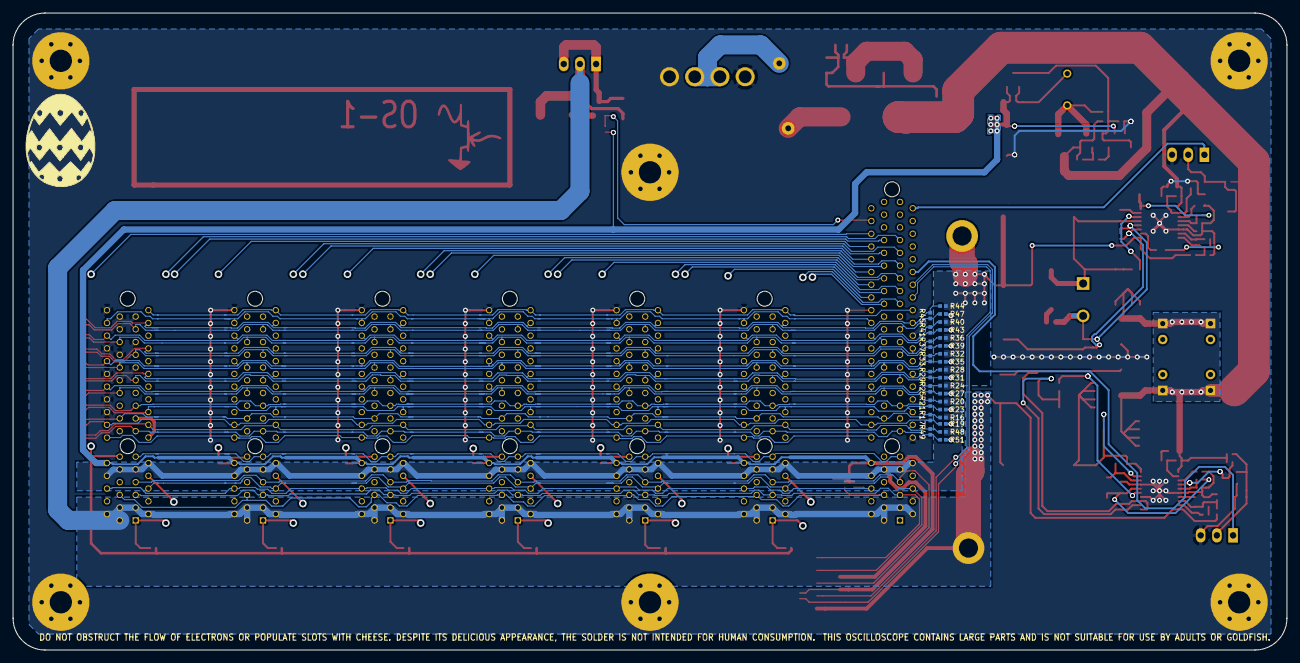
[picture p43: board os-backplane.kicad_pcb from below]

Board: 4 copper layers, 200.0 x 100.0 mm, 160 parts (27 on the bottom side), 99 nets.
