koson/os/(commit log)

2015-02-08 Initial checkin
    [Power.sch, Supply12V.sch, Supply3V3.sch, os-backplane.kicad_pcb, os-backplane.sch]
2015-02-08 Reannotated parts
    [Power.sch, Supply12V.sch, Supply3V3.sch, os-backplane.kicad_pcb, os-backplane.sch]
2015-02-08 Added extra supports
    [Power.sch, Supply12V.sch, Supply3V3.sch, os-backplane.kicad_pcb, os-backplane.sch]
2015-02-09 Added Easter egg
    [os-backplane.kicad_pcb]
2015-02-09 Silkscreen and 3D touchups
    [Power.sch, Supply12V.sch, Supply3V3.sch, os-backplane.kicad_pcb]
2015-02-09 Researched alternative DC-DC controllers
    [Supply12V.sch, Supply3V3.sch]
2015-02-09 Changed BSS138 to MMUN221
    [Power.sch, Supply12V.sch, Supply3V3.sch, os-backplane.kicad_pcb]
2015-02-09 Added auto-renders
    [os-backplane-B_Cu.gbl, os-backplane-B_Mask.gbs, os-backplane-B_Paste.gbp, os-backplane-B_SilkS.gbo, os-backplane-Edge_Cuts.gbr, os-backplane-F_Cu.gtl, os-backplane-F_Fab.gbr, os-backplane-F_Mask.gts]
2015-02-09 Corrected thermal reliefs
    [os-backplane-B_Paste.gbp, os-backplane-F_Fab.gbr, os-backplane-F_Paste.gtp, os-backplane-NPTH.XLN, os-backplane.GBL, os-backplane.GBO, os-backplane.GBS, os-backplane.GKO]
2015-02-10 Added power supply load test points
    [Power.sch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]
2015-02-15 Reorganized to single repository
    [Power.sch, Supply12V.sch, Supply3V3.sch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]
2015-02-16 Added attenuator schematic
2015-02-23 Finished to send to fab
    [Power.sch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]
2015-02-25 Frontend amplifier section
    [Atten1.sch, frontend.sch]
2015-05-10 Frontend schematic ready to go to layout
    [Atten1.sch, Channel.sch, LevelShifters.sch, Microcontroller.sch, Power.sch, frontend.kicad_pcb, frontend.sch, psu3v3.kicad_pcb]
2015-05-11 Route PCB
    [Channel.sch, LevelShifters.sch, Microcontroller.sch, Power.sch, frontend.kicad_pcb]
2015-05-12 Work more on routing
    [Channel.sch, LevelShifters.sch, Microcontroller.sch, Power.sch, frontend.kicad_pcb]
2015-05-15 More layout work
    [Channel.sch, LevelShifters.sch, Microcontroller.sch, Power.sch, frontend.kicad_pcb, frontend.sch]
2015-05-15 Schematic touchups
    [Channel.sch, LevelShifters.sch, Microcontroller.sch, Power.sch, frontend.sch]
2015-05-15 Route #IRQ and #PERST
    [Channel.sch, LevelShifters.sch, Microcontroller.sch, Power.sch, frontend.kicad_pcb, frontend.sch]
2015-05-15 Remove old schematic file
    [Atten1.sch]
2015-05-15 Reannotate schematic/PCB
    [Channel.sch, LevelShifters.sch, Microcontroller.sch, Power.sch, frontend.kicad_pcb, frontend.sch]
2015-05-16 Add bypass capacitor around AC coupling capacitors
    [Channel.sch, LevelShifters.sch, Microcontroller.sch, Power.sch, frontend.kicad_pcb, frontend.sch]
2015-05-16 Reannotate after adding parts
    [Channel.sch, LevelShifters.sch, Microcontroller.sch, Power.sch, frontend.kicad_pcb]
2015-05-16 Open mask under thermal pads
    [frontend.kicad_pcb]
2015-05-16 Add testpoints
    [Channel.sch, LevelShifters.sch, Microcontroller.sch, Power.sch, frontend.kicad_pcb, frontend.sch]
2015-05-16 Digital decoupling/termination tweaks
    [Channel.sch, Microcontroller.sch, frontend.kicad_pcb, frontend.sch]
2015-05-18 Schematic cleanup
    [Channel.sch, LevelShifters.sch, Microcontroller.sch, Power.sch, frontend.kicad_pcb, frontend.sch]
2015-05-18 Cleanup offset compensation system
    [Channel.sch, LevelShifters.sch, Microcontroller.sch, Power.sch, frontend.kicad_pcb, frontend.sch]
2015-05-25 Even more layout tweaks
    [Channel.sch, LevelShifters.sch, Microcontroller.sch, Power.sch, frontend.kicad_pcb, frontend.sch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]
2015-05-25 Switch acq connectors to SATA
    [Channel.sch, frontend.kicad_pcb, frontend.sch]
2015-05-25 Fix final gain stage resistors
    [Channel.sch]
2015-05-28 More routing adjustments
    [Channel.sch, LevelShifters.sch, Microcontroller.sch, Power.sch, frontend.kicad_pcb, frontend.sch]
2015-05-28 Update gerbers
    [frontend.kicad_pcb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]
2015-05-29 Finally finish the final layout finally
    [Channel.sch, LevelShifters.sch, Microcontroller.sch, Power.sch, frontend.kicad_pcb, frontend.sch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]
2015-05-30 Add pin definitions
